bimanamara/Embedded-System/Fritzing/Untitled Sketch 2_bb.jpg

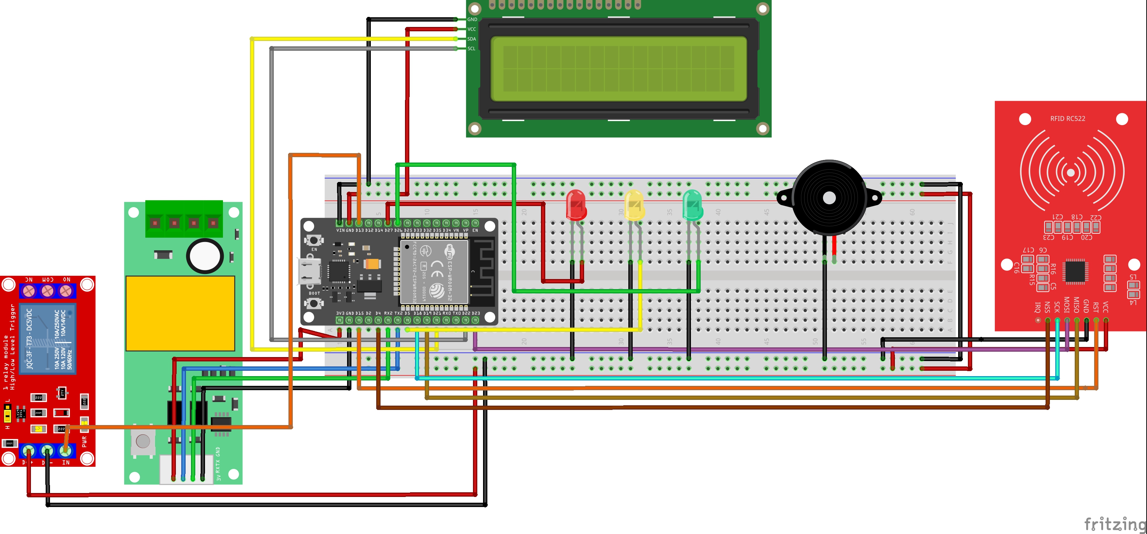
Fritzing/Untitled Sketch 2_bb.jpg
