bimanamara/Embedded-System/struktur file/Untitled-1.docx

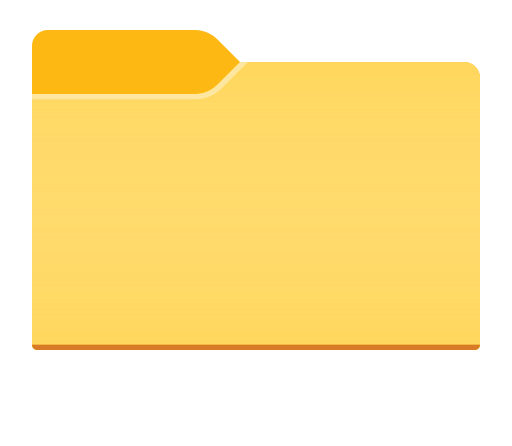
[picture p2: figure]

Kelompok24_Proyeksisben2

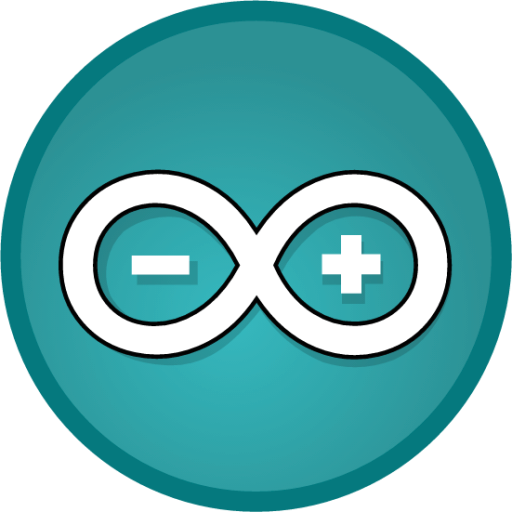
[picture p3: figure]
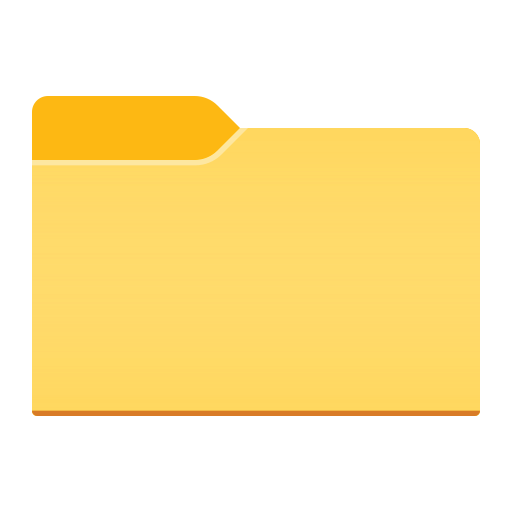
[picture p4: figure]
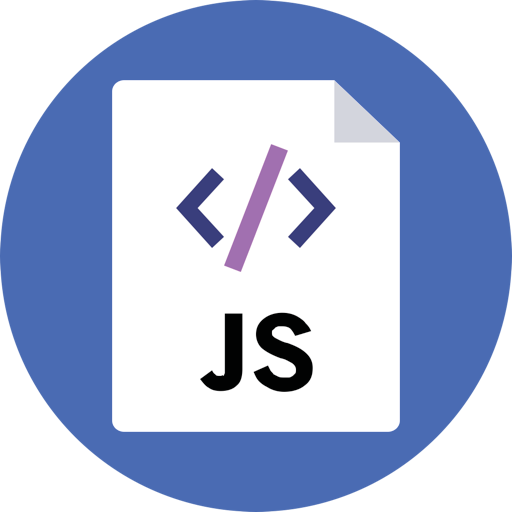
[picture p5: figure]
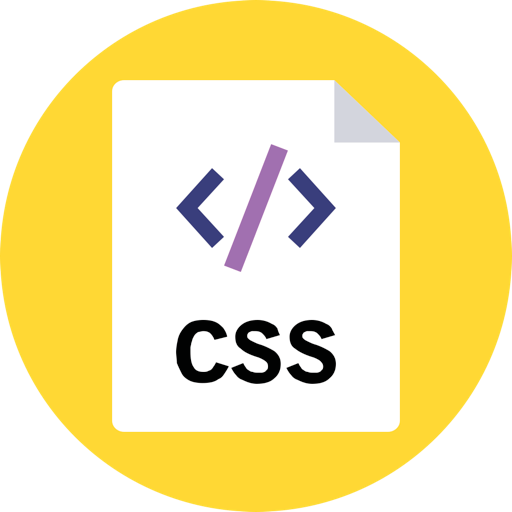
[picture p6: figure]
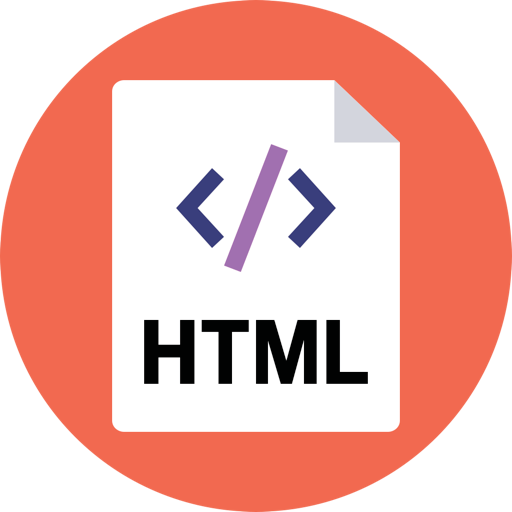
[picture p7: figure]
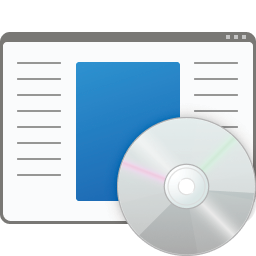
[picture p8: figure]

Kelompok24_Proyeksisben2.ino

data

ngrok.exe

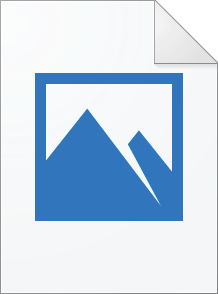
[picture p9: figure]

Webserver_spowcom.html style.css chart.css timer.png warn.png
