bimanamara/Embedded-System/Fritzing/Sketch.docx

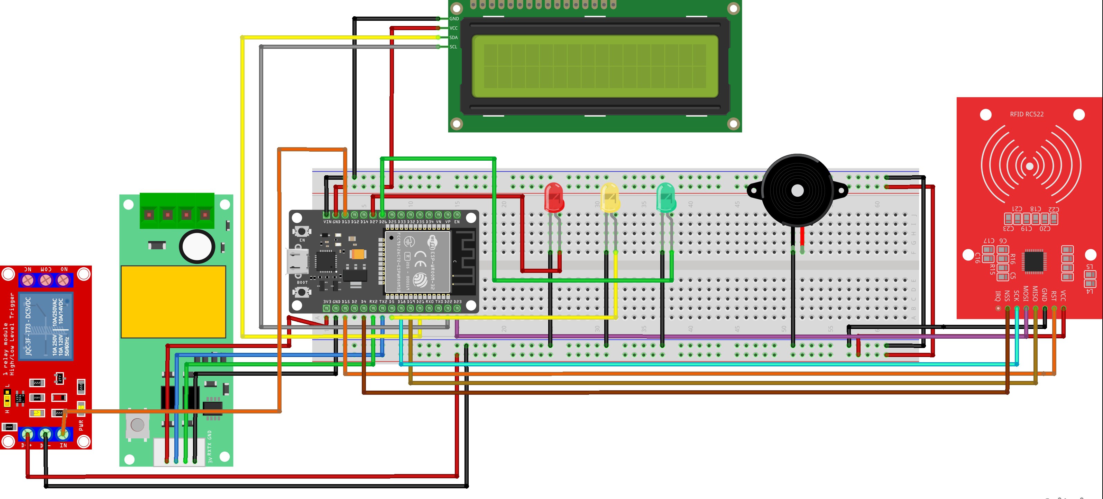
[picture p44: figure]
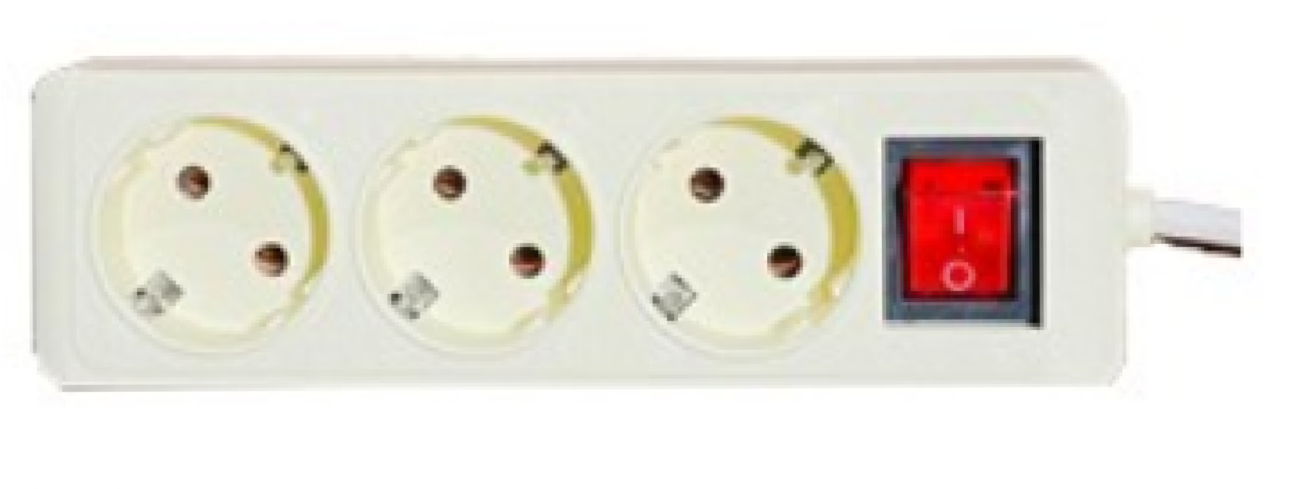
[picture p45: figure]
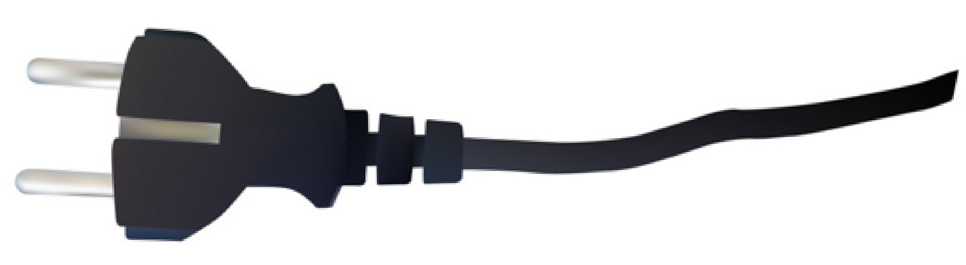
[picture p46: figure]
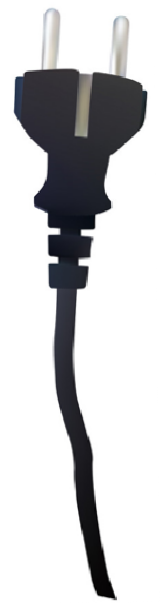
[picture p47: figure]
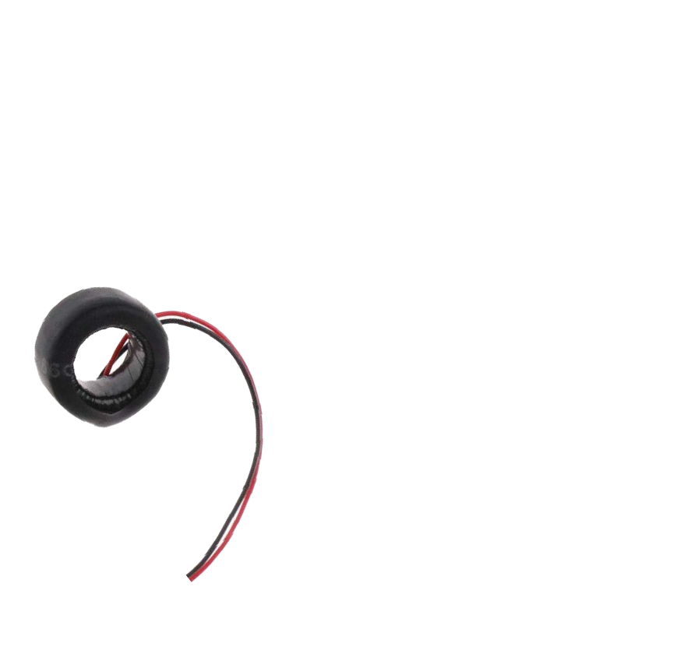
[picture p48: figure]

SDA
