bimanamara/Embedded-System/Fritzing/Sketch.pdf

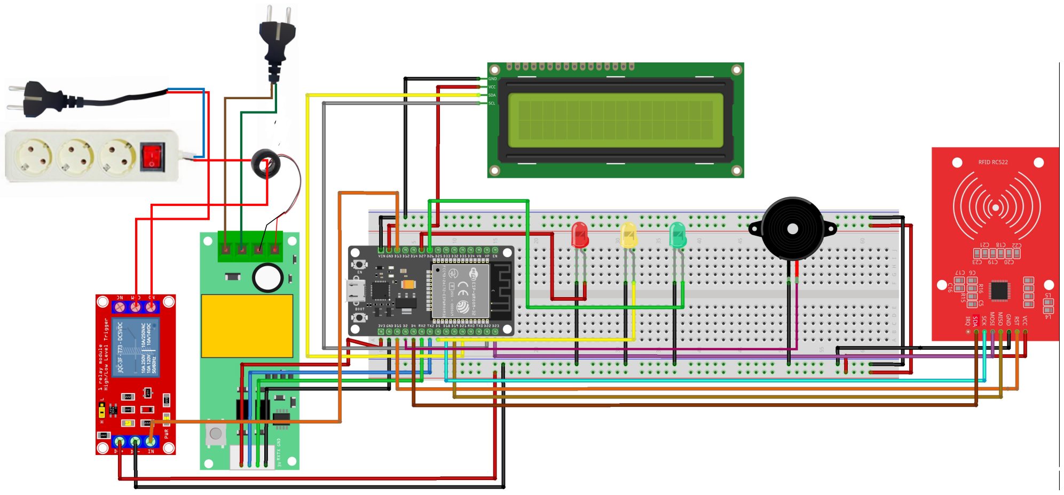
[picture p49: page 1]
SDA
