bimanamara/Embedded-System/(list of files, drawings)

Other design files:
Fritzing/Untitled Sketch 2.fzz
